samir-lab/diy_stm32_drone/PCB/原理图_STM32_无人机_2026-11-11/SCH_遥控_2026-11-11.pdf

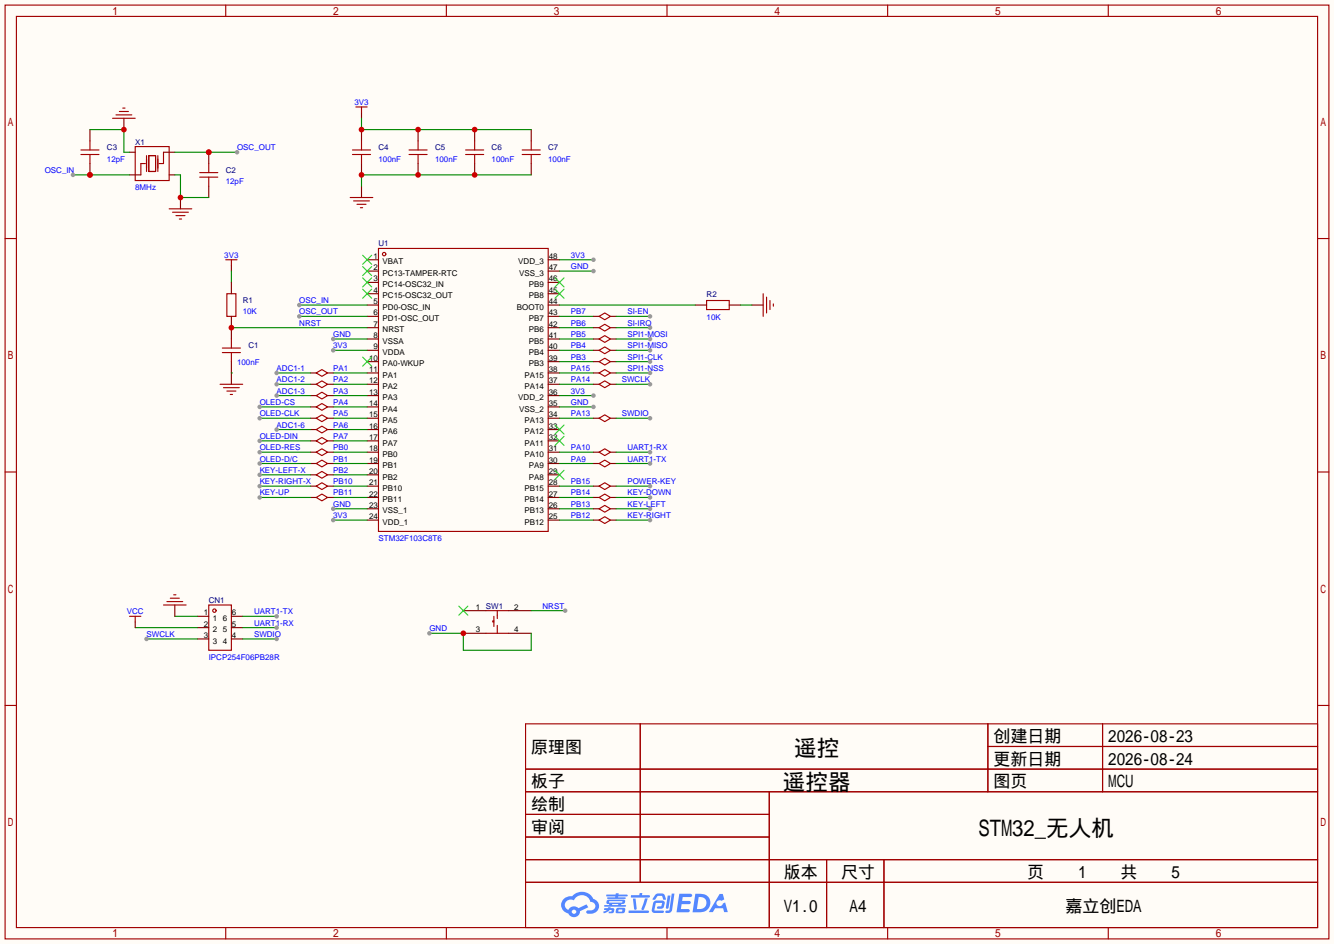
[picture p1: page 1]

原理图 | 遥控 | 创建日期 | 2026-08-23

更新日期 | 2026-08-24

板子 | 遥控器 | 图页 | MCU
绘制 | | STM32_无人机
审阅

V1.0 | A4 | 嘉立创EDA

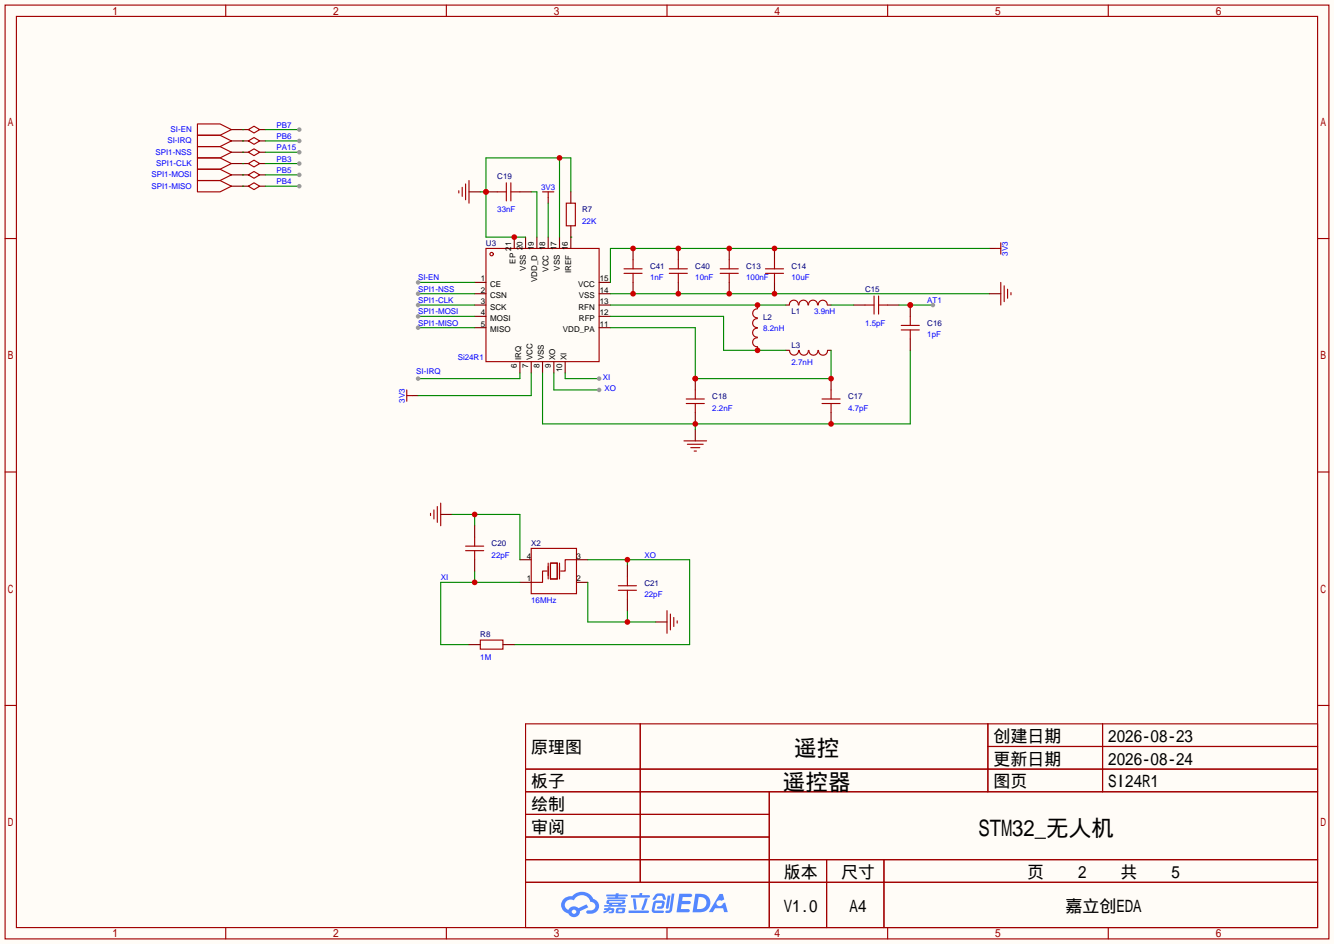
[picture p2: page 2]

原理图 | 遥控 | 创建日期 | 2026-08-23

更新日期 | 2026-08-24

板子 | 遥控器 | 图页 | SI24R1
绘制 | | STM32_无人机
审阅

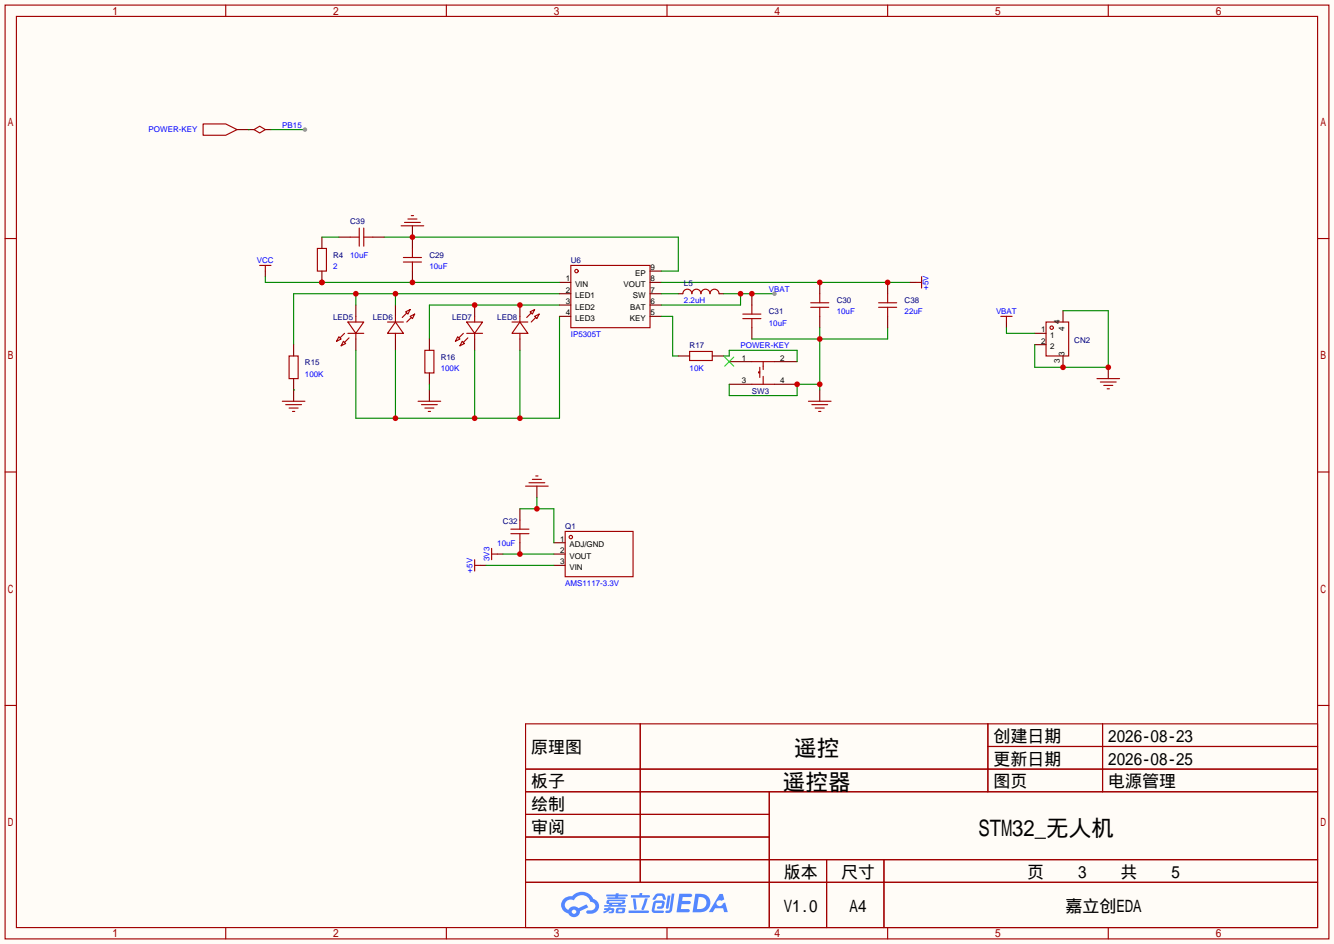
[picture p3: page 3]

原理图 | 遥控 | 创建日期 | 2026-08-23

更新日期 | 2026-08-25

板子 | 遥控器 | 图页 | 电源管理
绘制 | | STM32_无人机
审阅

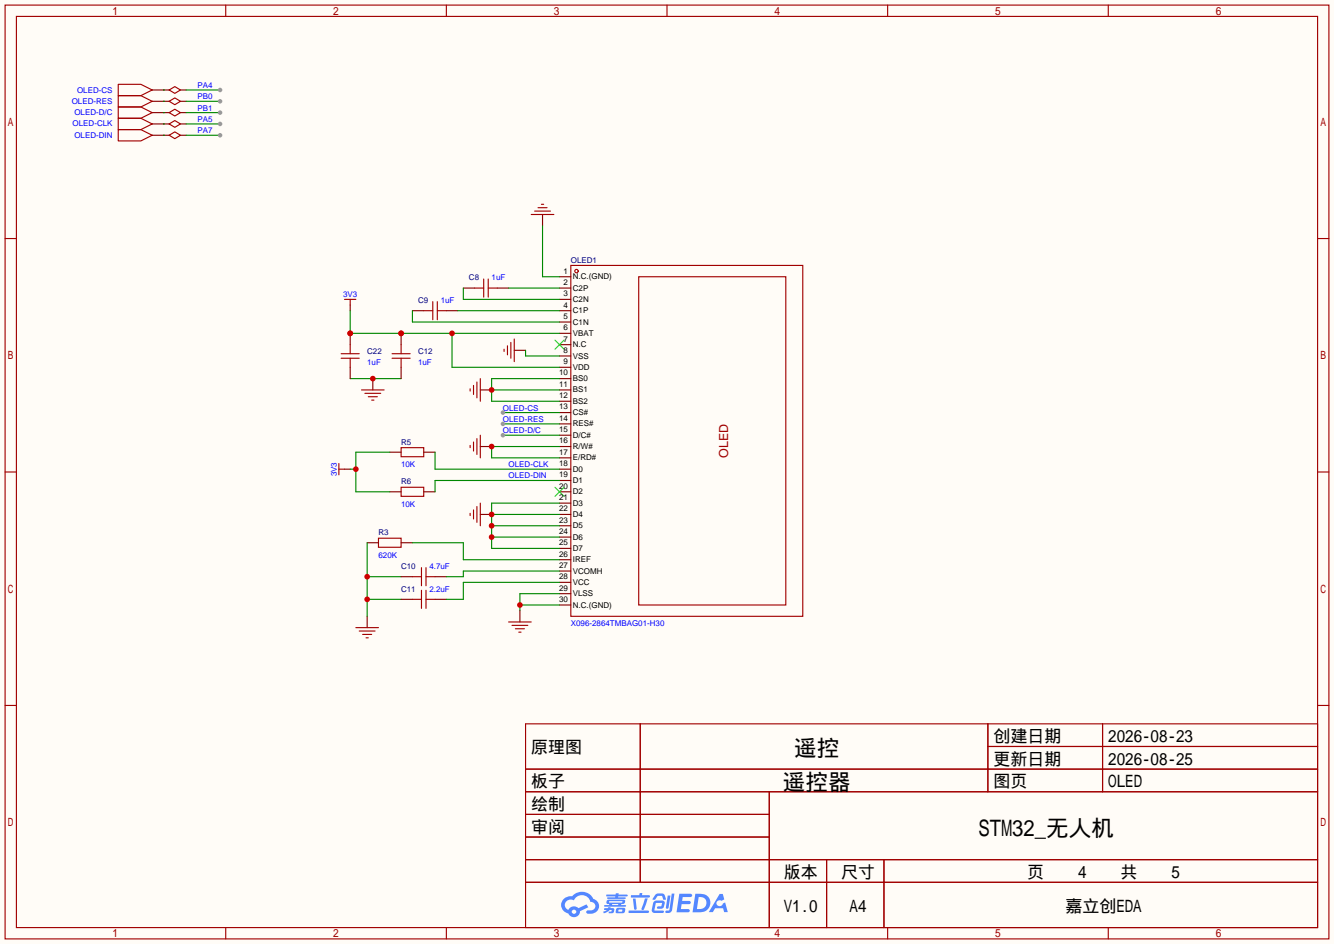
[picture p4: page 4]

原理图 | 遥控 | 创建日期 | 2026-08-23

更新日期 | 2026-08-25

板子 | 遥控器 | 图页 | OLED
绘制 | | STM32_无人机
审阅

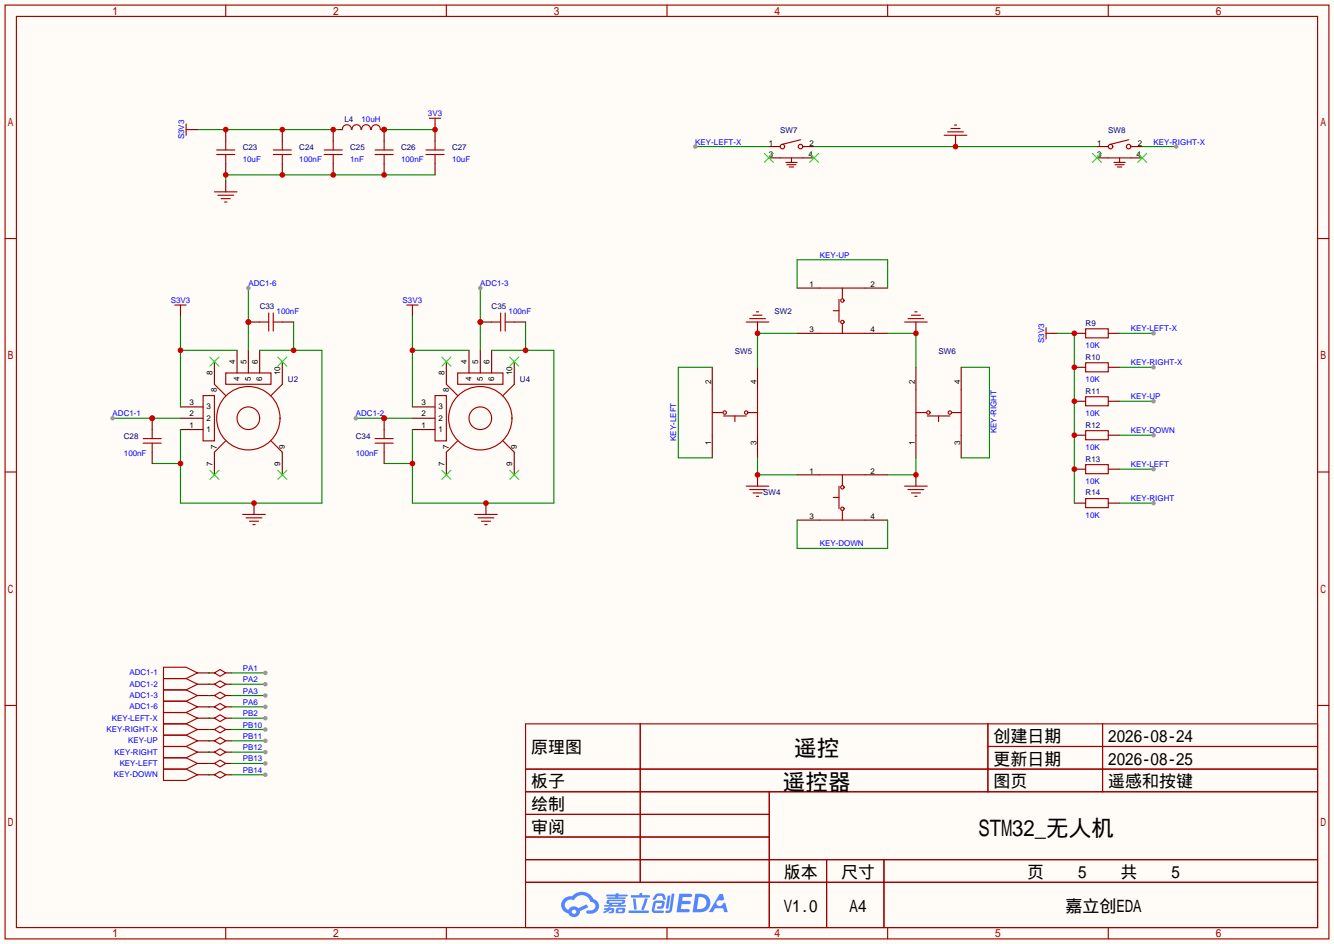
[picture p5: page 5]

原理图 | 遥控 | 创建日期 | 2026-08-24

更新日期 | 2026-08-25

板子 | 遥控器 | 图页 | 遥感和按键
绘制 | | STM32_无人机
审阅
