samir-lab/diy_stm32_drone/PCB/原理图_STM32_无人机_2026-11-11/SCH_飞控_2026-11-11.pdf

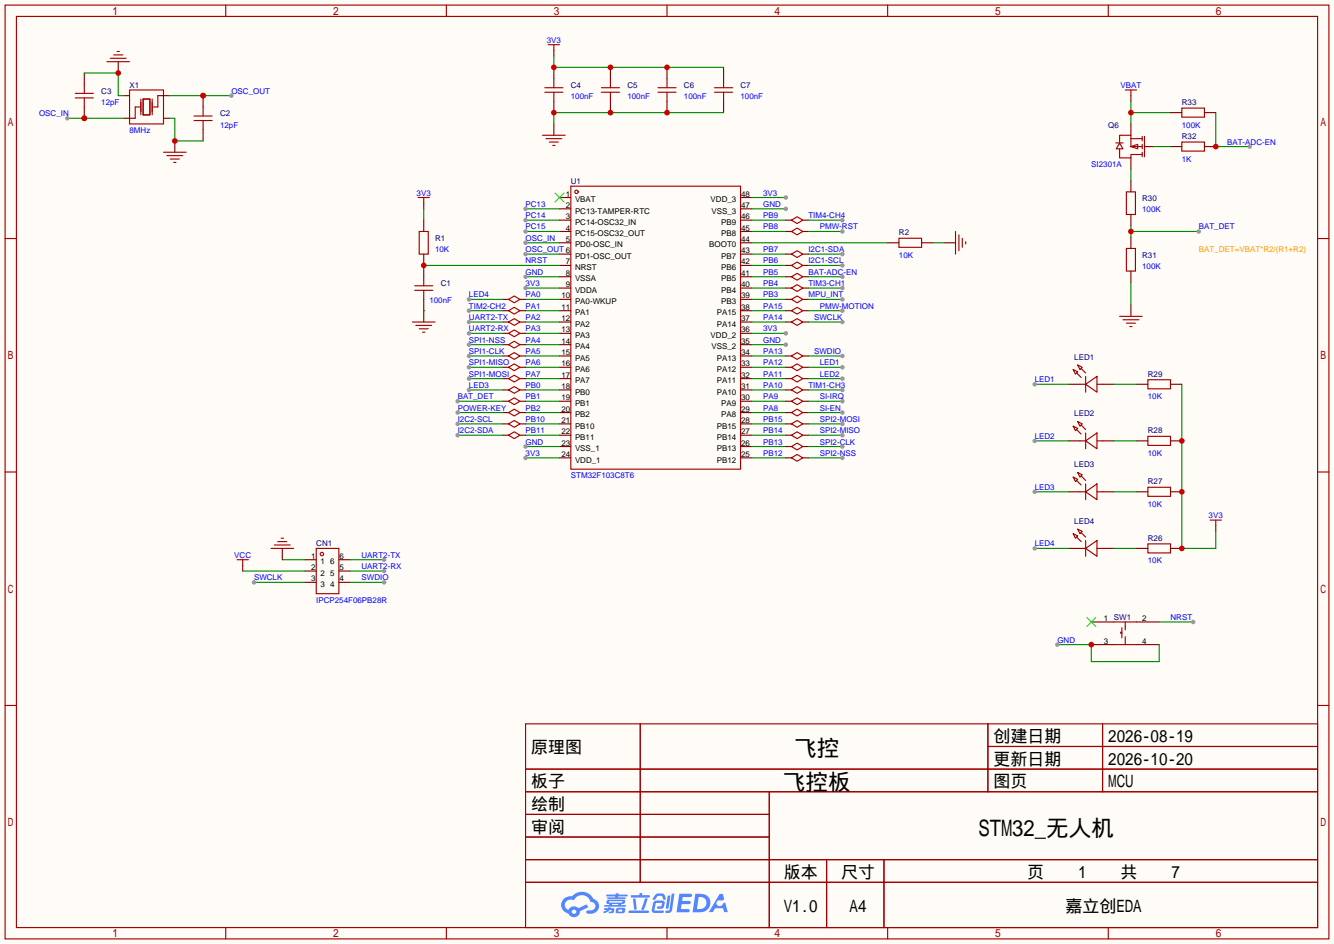
[picture p6: page 1]

原理图 | 飞控 | 创建日期 | 2026-08-19

更新日期 | 2026-10-20

板子 | 飞控板 | 图页 | MCU
绘制 | | STM32_无人机
审阅

V1.0 | A4 | 嘉立创EDA

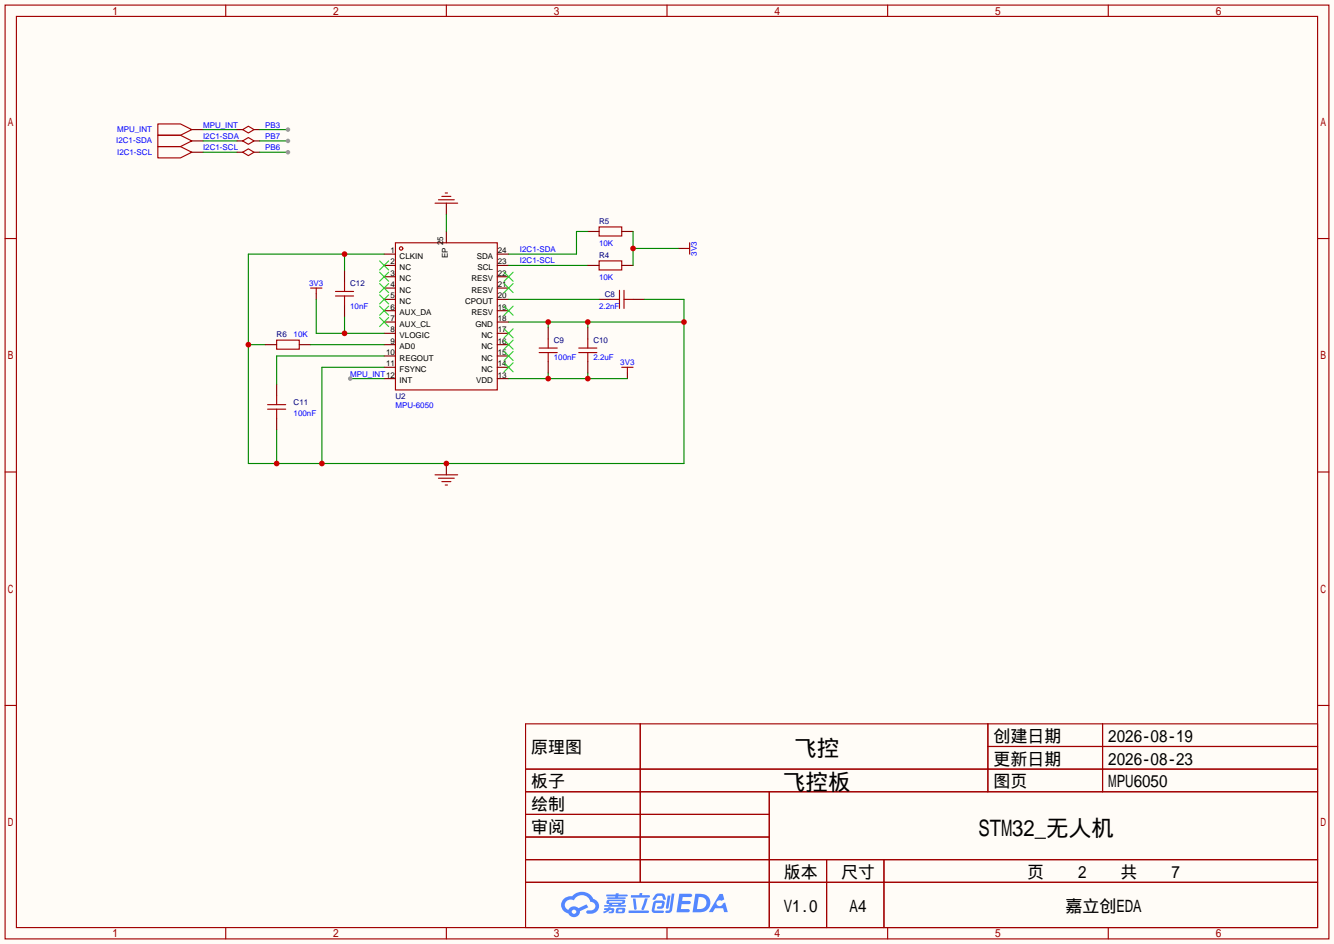
[picture p7: page 2]

原理图 | 飞控 | 创建日期 | 2026-08-19

更新日期 | 2026-08-23

板子 | 飞控板 | 图页 | MPU6050
绘制 | | STM32_无人机
审阅

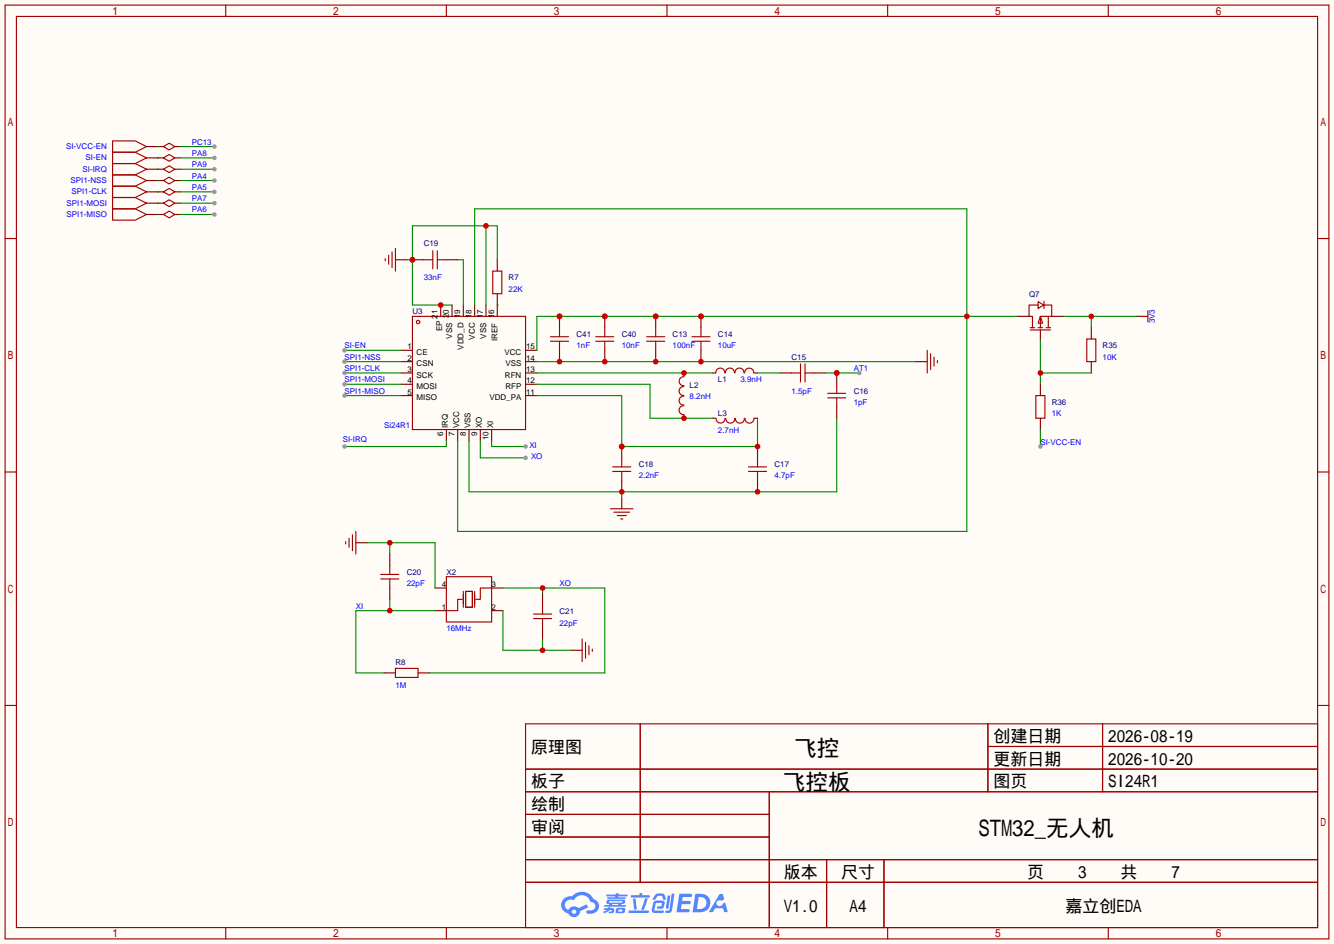
[picture p8: page 3]

原理图 | 飞控 | 创建日期 | 2026-08-19

更新日期 | 2026-10-20

板子 | 飞控板 | 图页 | SI24R1
绘制 | | STM32_无人机
审阅

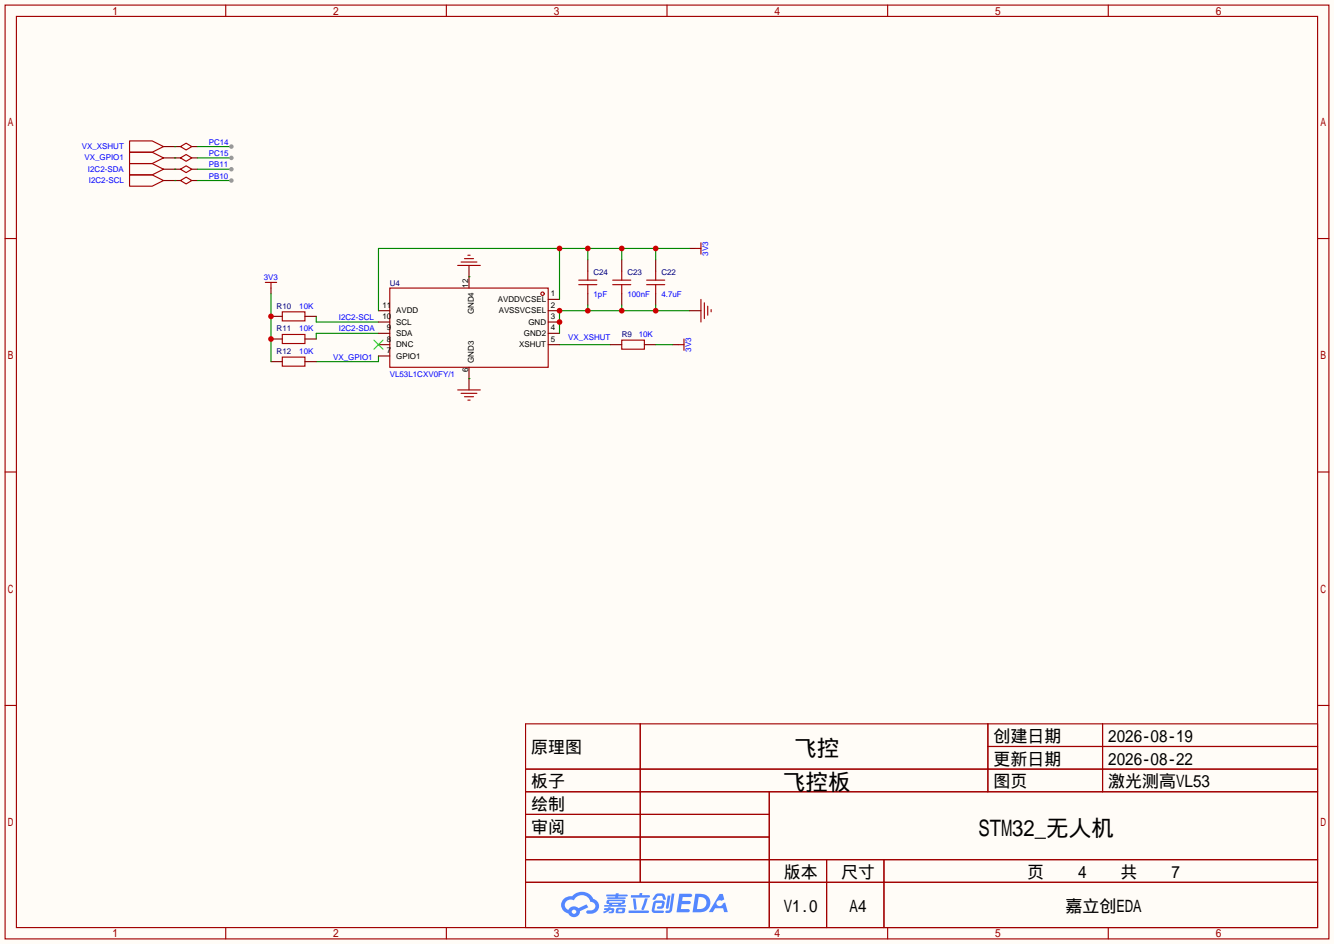
[picture p9: page 4]

原理图 | 飞控 | 创建日期 | 2026-08-19

更新日期 | 2026-08-22

板子 | 飞控板 | 图页 | 激光测高VL53
绘制 | | STM32_无人机
审阅

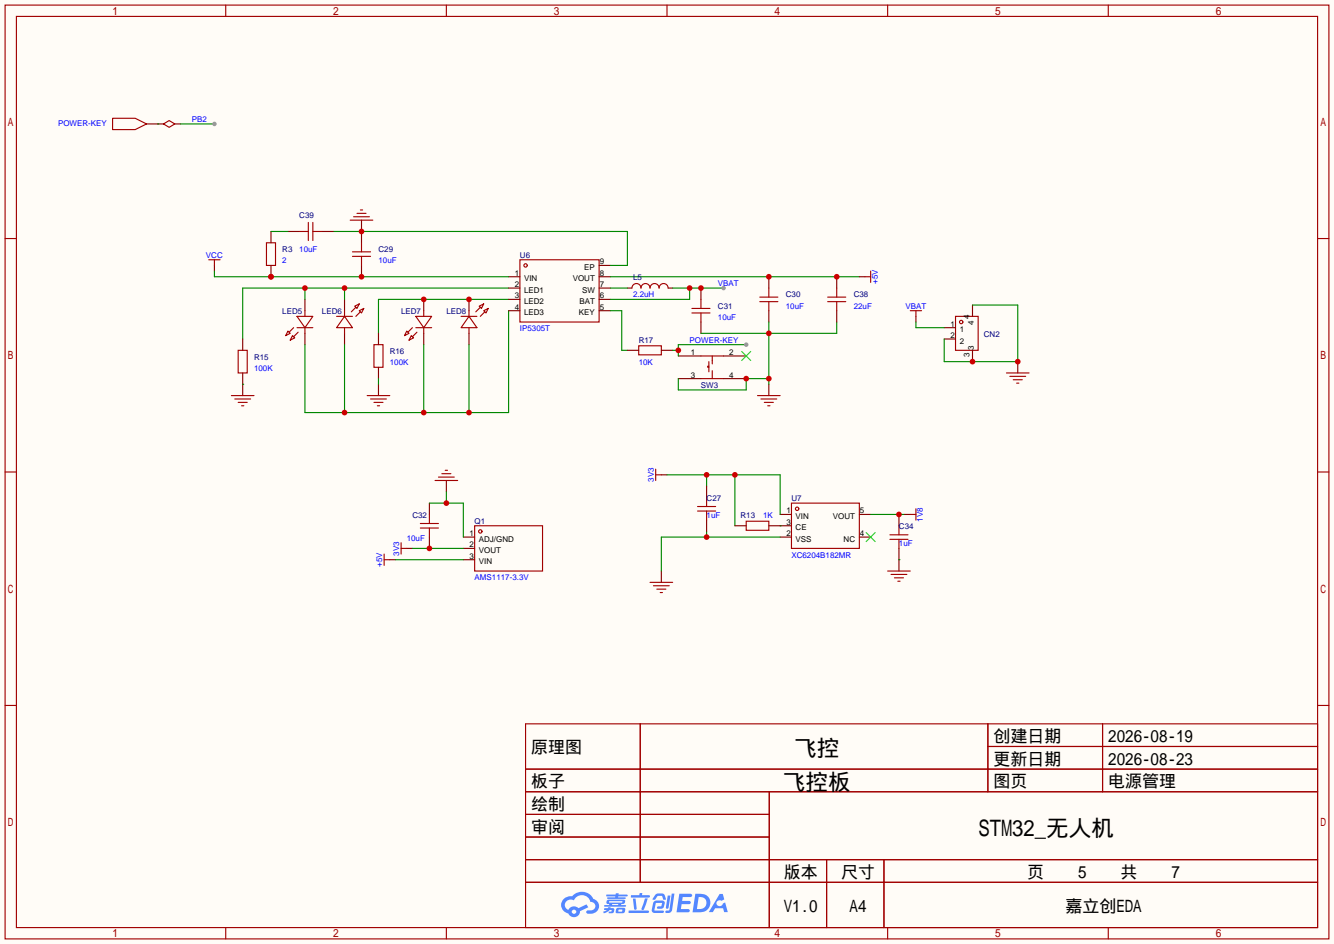
[picture p10: page 5]

原理图 | 飞控 | 创建日期 | 2026-08-19

更新日期 | 2026-08-23

板子 | 飞控板 | 图页 | 电源管理
绘制 | | STM32_无人机
审阅

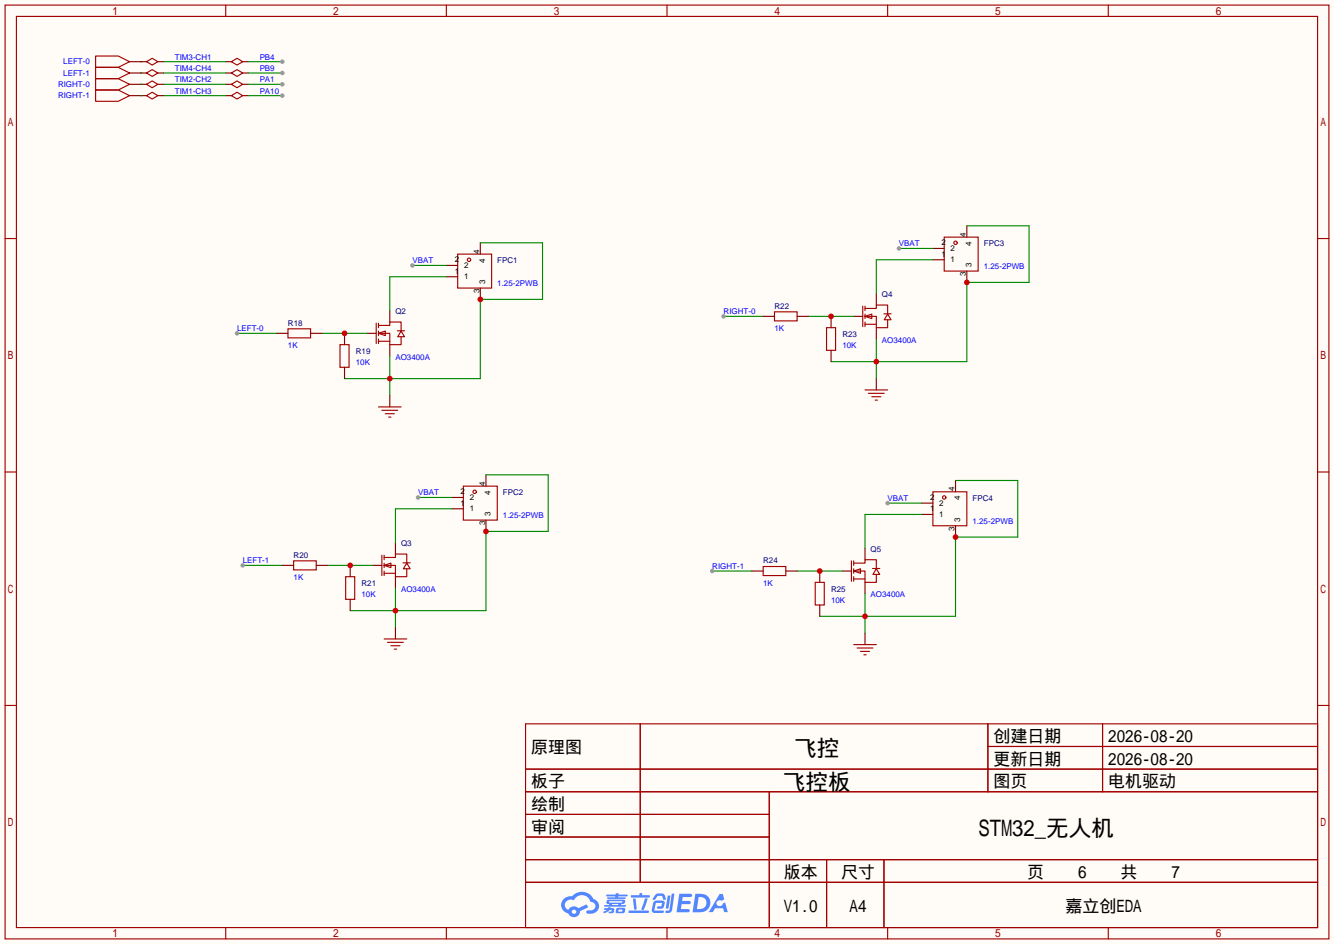
[picture p11: page 6]

原理图 | 飞控 | 创建日期 | 2026-08-20

更新日期 | 2026-08-20

板子 | 飞控板 | 图页 | 电机驱动
绘制 | | STM32_无人机
审阅

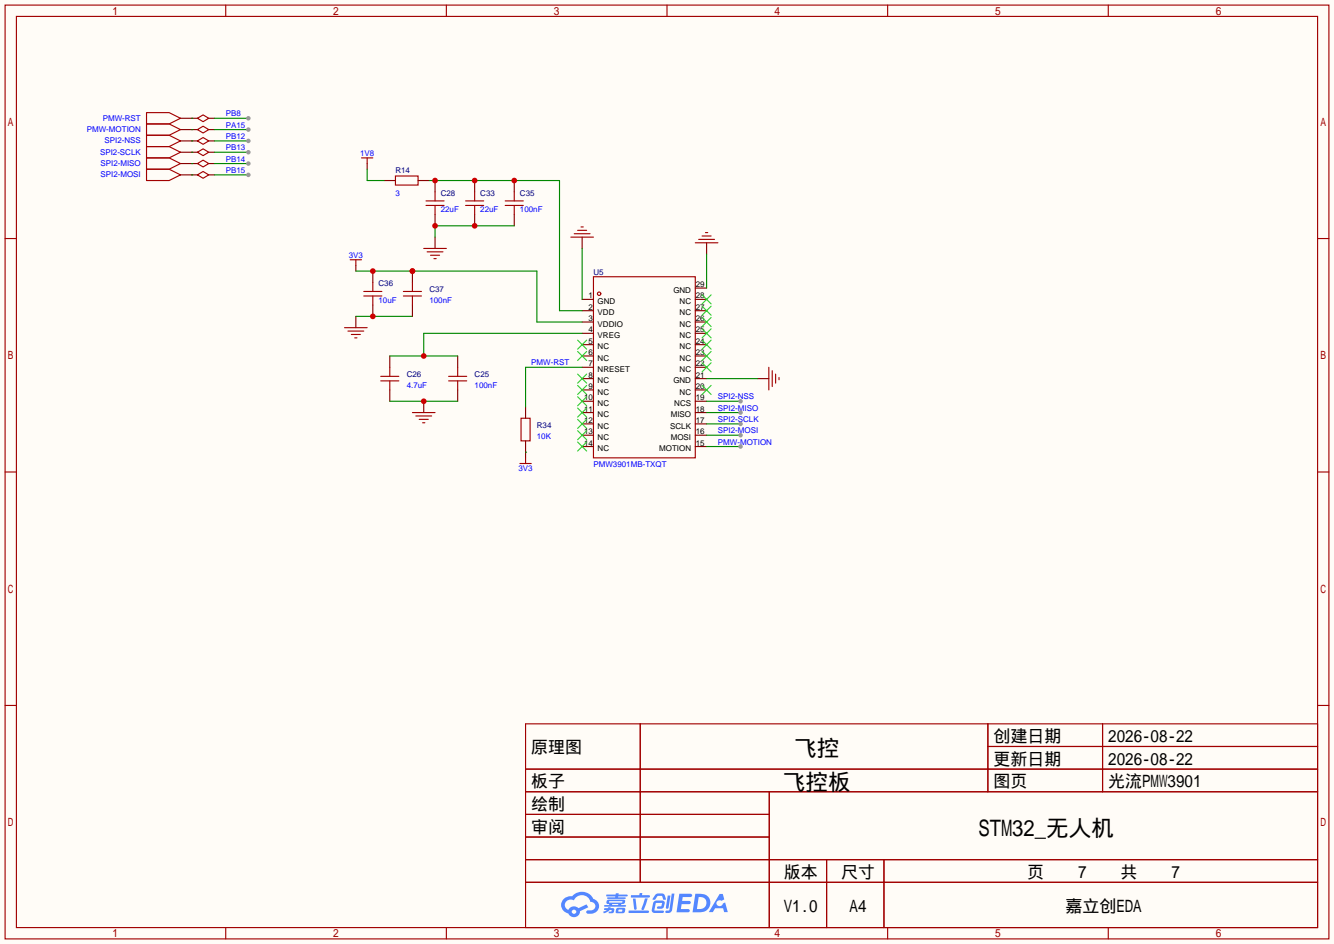
[picture p12: page 7]

原理图 | 飞控 | 创建日期 | 2026-08-22

更新日期 | 2026-08-22

板子 | 飞控板 | 图页 | 光流PMW3901
绘制 | | STM32_无人机
审阅
