samir-lab/diy_stm32_drone/(list of files, drawings)

Other design files:
PCB/ProPrj_STM32_无人机_2026-08-31.epro
PCB/ProPrj_STM32_无人机_2026-10-21.epro
