samir-lab/diy_stm32_drone/diy_drone/MDK-ARM/Interface/Int_Motor.h

#ifndef __INT_MOTOR_H__
#define __INT_MOTOR_H__

#include "tim.h"

typedef struct {
    TIM_HandleTypeDef *htim; // 定时器句柄
    uint16_t channel;        // 定时器通道
    int16_t speed;          // 当前速度值 speed范围为0-1000
} Motor_HandleTypeDef;


/**
 * 设置电机速度
 */
void Int_Motor_Set_Speed(Motor_HandleTypeDef *motor);

/**
 * 启动电机
 */
void Int_Motor_Start(Motor_HandleTypeDef *motor);

#endif // __INT_MOTOR_H__
