samir-lab/diy_stm32_drone/diy_drone_ctrl/MDK-ARM/Interface/oled/Int_OLED.c

#include "Int_Font.h"
#include "Int_OLED.h"
#include "stdlib.h"

//OLED的显存
//存放格式如下.
//[0]0 1 2 3 ... 127	
//[1]0 1 2 3 ... 127	
//[2]0 1 2 3 ... 127	
//[3]0 1 2 3 ... 127	
//[4]0 1 2 3 ... 127	
//[5]0 1 2 3 ... 127	
//[6]0 1 2 3 ... 127	
//[7]0 1 2 3 ... 127 			   
uint8_t OLED_GRAM[128][8];	 

//更新显存到LCD		 
void OLED_Refresh_Gram(void)
{
	uint8_t i,n;		    
	for(i=0; i<8; i++)  
	{  
		OLED_WR_Byte (0xb0 + i, OLED_CMD);    //设置页地址（0~7）
		OLED_WR_Byte (0x00, OLED_CMD);      //设置显示位置—列低地址
		OLED_WR_Byte (0x10, OLED_CMD);      //设置显示位置—列高地址   
		for(n=0; n<128; n++)
            OLED_WR_Byte(OLED_GRAM[n][i], OLED_DATA); 
	}
}

/**
 * 写入一个字节。
 * dat:要写入的数据/命令
 * cmd:数据/命令标志 0,表示命令;1,表示数据;
 */
void OLED_WR_Byte(uint8_t dat,uint8_t cmd)
{	
	uint8_t i;			  
	if(cmd)
	  OLED_DC_Set();
	else 
	  OLED_DC_Clr();		  
	OLED_CS_Clr();
	for(i=0; i<8; i++)
	{			  
		OLED_SCLK_Clr();
		if(dat & 0x80)
		   OLED_SDIN_Set();
		else 
		   OLED_SDIN_Clr();
		OLED_SCLK_Set();
		dat <<= 1;   
	}				 		  
	OLED_CS_Set();
	OLED_DC_Set();   	  
}
	  	  
/**
 * 开启OLED显示  
 */  
void OLED_Display_On(void)
{
	OLED_WR_Byte(0X8D, OLED_CMD);  //SET DCDC命令
	OLED_WR_Byte(0X14, OLED_CMD);  //DCDC ON
	OLED_WR_Byte(0XAF, OLED_CMD);  //DISPLAY ON
}
/**
 * 关闭OLED显示 
 */     
void OLED_Display_Off(void)
{
	OLED_WR_Byte(0X8D, OLED_CMD);  //SET DCDC命令
	OLED_WR_Byte(0X10, OLED_CMD);  //DCDC OFF
	OLED_WR_Byte(0XAE, OLED_CMD);  //DISPLAY OFF
}

/**
 * 清屏函数,清完屏,整个屏幕是黑色的!和没点亮一样!!!
 */
void OLED_Clear(void)  
{  
	uint8_t i,n;  
	for(i=0; i<8; i++)
        for(n=0; n<128; n++)
            OLED_GRAM[n][i] = 0X00;  
	OLED_Refresh_Gram(); //更新显示
}

/**
 * 画点 
 * x:0~127 
 * y:0~63
 * t:1 填充 0,清空	
 */
void OLED_DrawPoint(uint8_t x,uint8_t y,uint8_t t)
{
	uint8_t pos,bx,temp = 0;
	if(x > 127 || y > 63) 
        return; //超出范围了.
	pos = 7 - y / 8;
	bx = y % 8;
	temp = 1 << (7 - bx);
	if(t)
        OLED_GRAM[x][pos] |= temp;
	else 
        OLED_GRAM[x][pos] &= ~temp;	    
}

/**
 * x1,y1,x2,y2 填充区域的对角坐标
 * 确保x1<=x2;y1<=y2 0<=x1<=127 0<=y1<=63
 * dot:0,清空;1,填充	  
 */
void OLED_Fill(uint8_t x1, uint8_t y1, uint8_t x2, uint8_t y2, uint8_t dot)  
{  
	uint8_t x, y;  
	for(x = x1; x <= x2; x++)
	{
		for(y = y1; y <= y2; y++)
            OLED_DrawPoint(x, y, dot);
	}													    
	OLED_Refresh_Gram(); //更新显示
}

/**
 * 在指定位置显示一个字符,包括部分字符
 * x:0~127
 * y:0~63
 * mode:0,反白显示;1,正常显示
 * size:选择字体 16/12 
 */
void OLED_ShowChar(uint8_t x,uint8_t y,uint8_t chr,uint8_t size,uint8_t mode)
{      			    
	uint8_t temp, t, t1;
	uint8_t y0 = y;
	chr = chr - ' '; //得到偏移后的值				   
    for(t = 0; t < size; t++)
    {   
		if( size == 12) 
            temp = oled_asc2_1206[chr][t];  //调用1206字体
		else 
            temp = oled_asc2_1608[chr][t];	//调用1608字体 	                          
        for(t1 = 0; t1 < 8; t1++)
		{
			if(temp & 0x80)
                OLED_DrawPoint(x, y, mode);
			else 
                OLED_DrawPoint(x, y, !mode);
			temp <<= 1;
			y++;
			if((y - y0) == size)
			{
				y = y0;
				x++;
				break;
			}
		}  	 
    }          
}

/**
 * 显示字符串
 * x,y:起点坐标
 * *p:字符串起始地址
 * 大小
 * 模式
 */
void OLED_ShowString(uint8_t x, uint8_t y, const uint8_t *p, uint8_t size, uint8_t mode)
{
    #define MAX_CHAR_POSX 122
    #define MAX_CHAR_POSY 58          
    while(*p != '\0')
    {       
        if(x > MAX_CHAR_POSX) 
        {
            x = 0;
            y += 16;
        }
        if(y > MAX_CHAR_POSY)
        {
            y = x = 0;
            OLED_Clear();
        }
        OLED_ShowChar(x, y, *p, size, mode);	 
        x += 8;
        p++;
    }  
}	   

/**
 * 初始化
 */
void OLED_Init(void)
{ 	
 	GPIO_InitTypeDef  GPIO_InitStructure = {0};
    // GPIOA
 	HAL_GPIO_WritePin(OLED_CS_GPIO, OLED_CS_Pin, GPIO_PIN_SET);
    HAL_GPIO_WritePin(OLED_SDIN_GPIO, OLED_SDIN_Pin, GPIO_PIN_SET);
	HAL_GPIO_WritePin(OLED_SCLK_GPIO, OLED_SCLK_Pin, GPIO_PIN_RESET);
	GPIO_InitStructure.Pin = OLED_CS_Pin | OLED_SDIN_Pin | OLED_SCLK_Pin;
	GPIO_InitStructure.Mode = GPIO_MODE_OUTPUT_PP;
	GPIO_InitStructure.Pull = GPIO_NOPULL;
	GPIO_InitStructure.Speed = GPIO_SPEED_FREQ_HIGH;
	HAL_GPIO_Init(GPIOA, &GPIO_InitStructure);

    // GPIOB
 	HAL_GPIO_WritePin(OLED_RST_GPIO, OLED_RST_Pin, GPIO_PIN_SET);
    HAL_GPIO_WritePin(OLED_DC_GPIO, OLED_DC_Pin, GPIO_PIN_SET);
	GPIO_InitStructure.Pin = OLED_RST_Pin | OLED_DC_Pin;
	GPIO_InitStructure.Mode = GPIO_MODE_OUTPUT_PP;
	GPIO_InitStructure.Pull = GPIO_NOPULL;
	GPIO_InitStructure.Speed = GPIO_SPEED_FREQ_HIGH;
	HAL_GPIO_Init(GPIOB, &GPIO_InitStructure);

	OLED_RST_Clr();
	HAL_Delay(100);
	OLED_RST_Set(); 
					  
	OLED_WR_Byte(0xAE, OLED_CMD); //关闭显示
    OLED_WR_Byte(0x00, OLED_CMD); // set low column address
    OLED_WR_Byte(0x10, OLED_CMD); // set high column address
	OLED_WR_Byte(0x40, OLED_CMD); // set start line address 设置显示开始行 [5:0],行数.
	OLED_WR_Byte(0x81, OLED_CMD); // set contrast control register 对比度设置
	OLED_WR_Byte(0xCF, OLED_CMD); // set SEG Output Current Brightness
	OLED_WR_Byte(0xA1, OLED_CMD); // set SEG/Column Mapping 0xa0左右反置 0xa1正常    
	OLED_WR_Byte(0xC0, OLED_CMD); // set COM/Row Scan Direction 0xc0上下反置 0xc8正常
	OLED_WR_Byte(0xA6, OLED_CMD); // set normal display 设置显示方式;bit0:1,反相显示;0,正常显示	
    OLED_WR_Byte(0xA8, OLED_CMD); // set multiplex ratio(1 to 64) 设置驱动路数
	OLED_WR_Byte(0x3F, OLED_CMD); // 1/64 duty 默认(1/64)
	OLED_WR_Byte(0xD3, OLED_CMD); // set display offset  设置显示偏移
	OLED_WR_Byte(0x00, OLED_CMD); // not offset
    OLED_WR_Byte(0xD5, OLED_CMD); // set display clock divide ratio/oscillator frequency 设置时钟分频因子,震荡频率
	OLED_WR_Byte(0x80, OLED_CMD); // set divide ratio, set clock as 100 Frames/Sec
	OLED_WR_Byte(0xD9, OLED_CMD); // set pre-charge period 设置预充电周期
	OLED_WR_Byte(0xF1, OLED_CMD); // set pre-charge as 15 Clocks & Discharge as 1 Clock
	OLED_WR_Byte(0xDA, OLED_CMD); // set com pins hardware configuration 设置COM硬件引脚配置
	OLED_WR_Byte(0x12, OLED_CMD); // [5:4]配置
	OLED_WR_Byte(0xDB, OLED_CMD); // set vcomh 电压倍率
	OLED_WR_Byte(0x30, OLED_CMD); // set vcom deselect level [6:4] 000,0.65*vcc;001,0.77*vcc;011,0.83*vcc;
	OLED_WR_Byte(0x20, OLED_CMD); // set page address mode 设置内存地址模式
	OLED_WR_Byte(0x02, OLED_CMD); // [1:0],00，列地址模式;01，行地址模式;10,页地址模式;默认10;
	OLED_WR_Byte(0xEF, OLED_CMD); //1~255;默认0X7F (亮度设置,越大越亮)
    OLED_WR_Byte(0x8D, OLED_CMD); // set charge pump enable 电荷泵设置
	OLED_WR_Byte(0x14, OLED_CMD); // set(0x10) disable bit2，开启/关闭
    OLED_Clear();
    OLED_WR_Byte(0xAF, OLED_CMD); // 开启显示
    
    debug_printf("OLED Init Ok!\r\n");
}
