samir-lab/diy_stm32_drone/diy_drone/MDK-ARM/Interface/Int_IP5305T.c

#include "Int_IP5305T.h"

/**
 * @brief 定期启动IP5305T，避免自动进入低功耗状态
 */
void Int_IP5305T_Start(void)
{
    // 拉低电源按键引脚，模拟按下电源键，启动IP5305T
    HAL_GPIO_WritePin(POWER_KEY_GPIO_Port, POWER_KEY_Pin, GPIO_PIN_RESET);
    // 延时100ms时间（30ms - 2s之间），确保按键被识别
    vTaskDelay(100);
    // 拉高电源按键引脚，模拟松开电源键
    HAL_GPIO_WritePin(POWER_KEY_GPIO_Port, POWER_KEY_Pin, GPIO_PIN_SET);
}

/**
 * @brief 关闭IP5305T电源
 */
void Int_IP5305T_Shutdown(void)
{
    // 连续按两次电源键，关闭IP5305T电源
    Int_IP5305T_Start();
    vTaskDelay(200);
    Int_IP5305T_Start();
}
