samir-lab/diy_stm32_drone/(commit log)

2026-08-31 init project
    [ProPrj_STM32_无人机_2026-08-31.epro]
2026-09-01 add si24r1 driver
2026-09-01 add si24r1 driver for ctrl
2026-10-04 add mpu6050 driver
2026-10-06 pid ctrl code
2026-10-06 adapt pid params
2026-10-07 add sensor driver
2026-10-10 debug driver
2026-10-13 PMW3901 Driver Complete
2026-10-14 pid adapt
2026-10-15 pid adapt stage 1
2026-10-15 pid adapt...
2026-10-16 pid adapt stage 2
2026-10-18 oled driver
2026-10-19 pid adapt stage 3
2026-10-20 upgrade pcb layout
    [ProPrj_STM32_无人机_2026-10-21.epro]
2026-11-09 pid adapt stage 4
2026-11-09 set defaut pid value
2026-11-09 update readme
    Added an image of the flight control board to the README and updated the TODO list wording.
