samir-lab/diy_stm32_drone/(notices)

Notices in the files:
diy_drone/Core/Inc/main.h:
Copyright (c) 2026 STMicroelectronics.
All rights reserved.
